freetronics/USBBoost/USBBoost.pdf

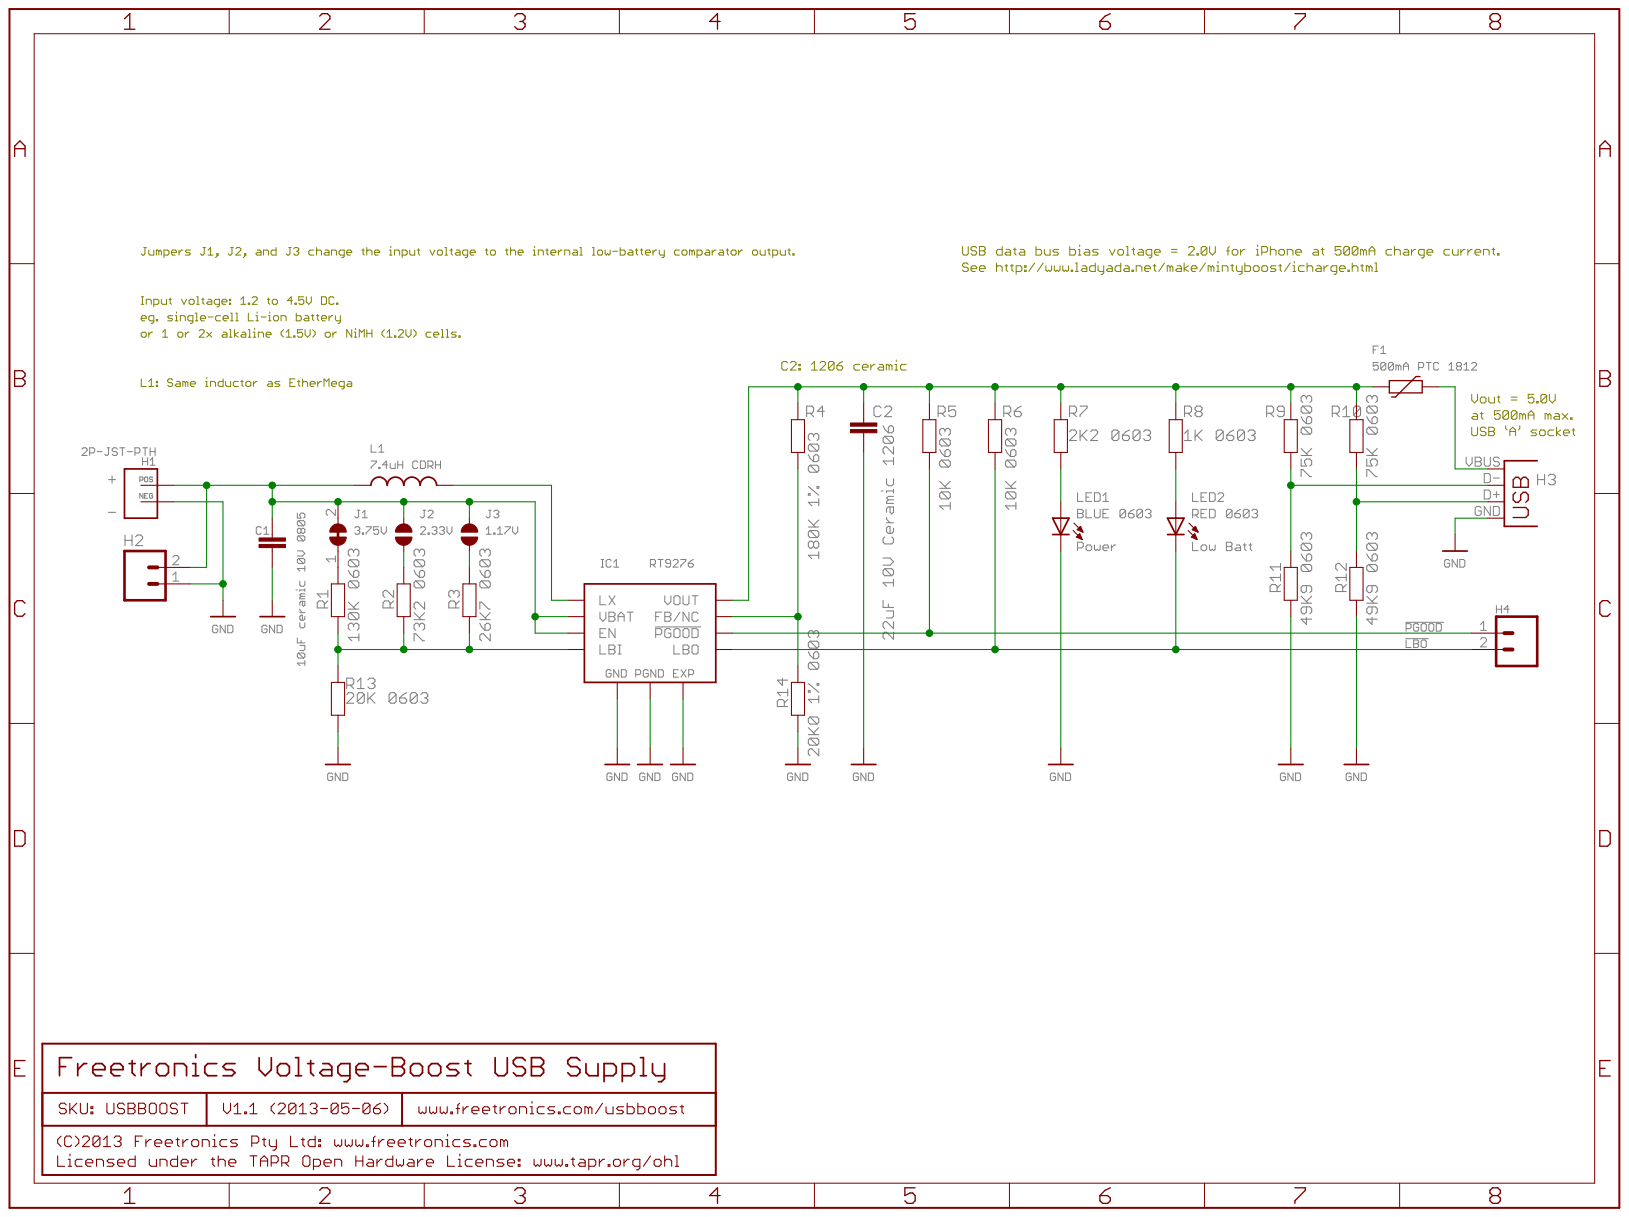
[picture p1: page 1]
