freetronics/USBBoost/USBBoost.brd

## EAGLE design USBBoost.brd (2013-05-06)

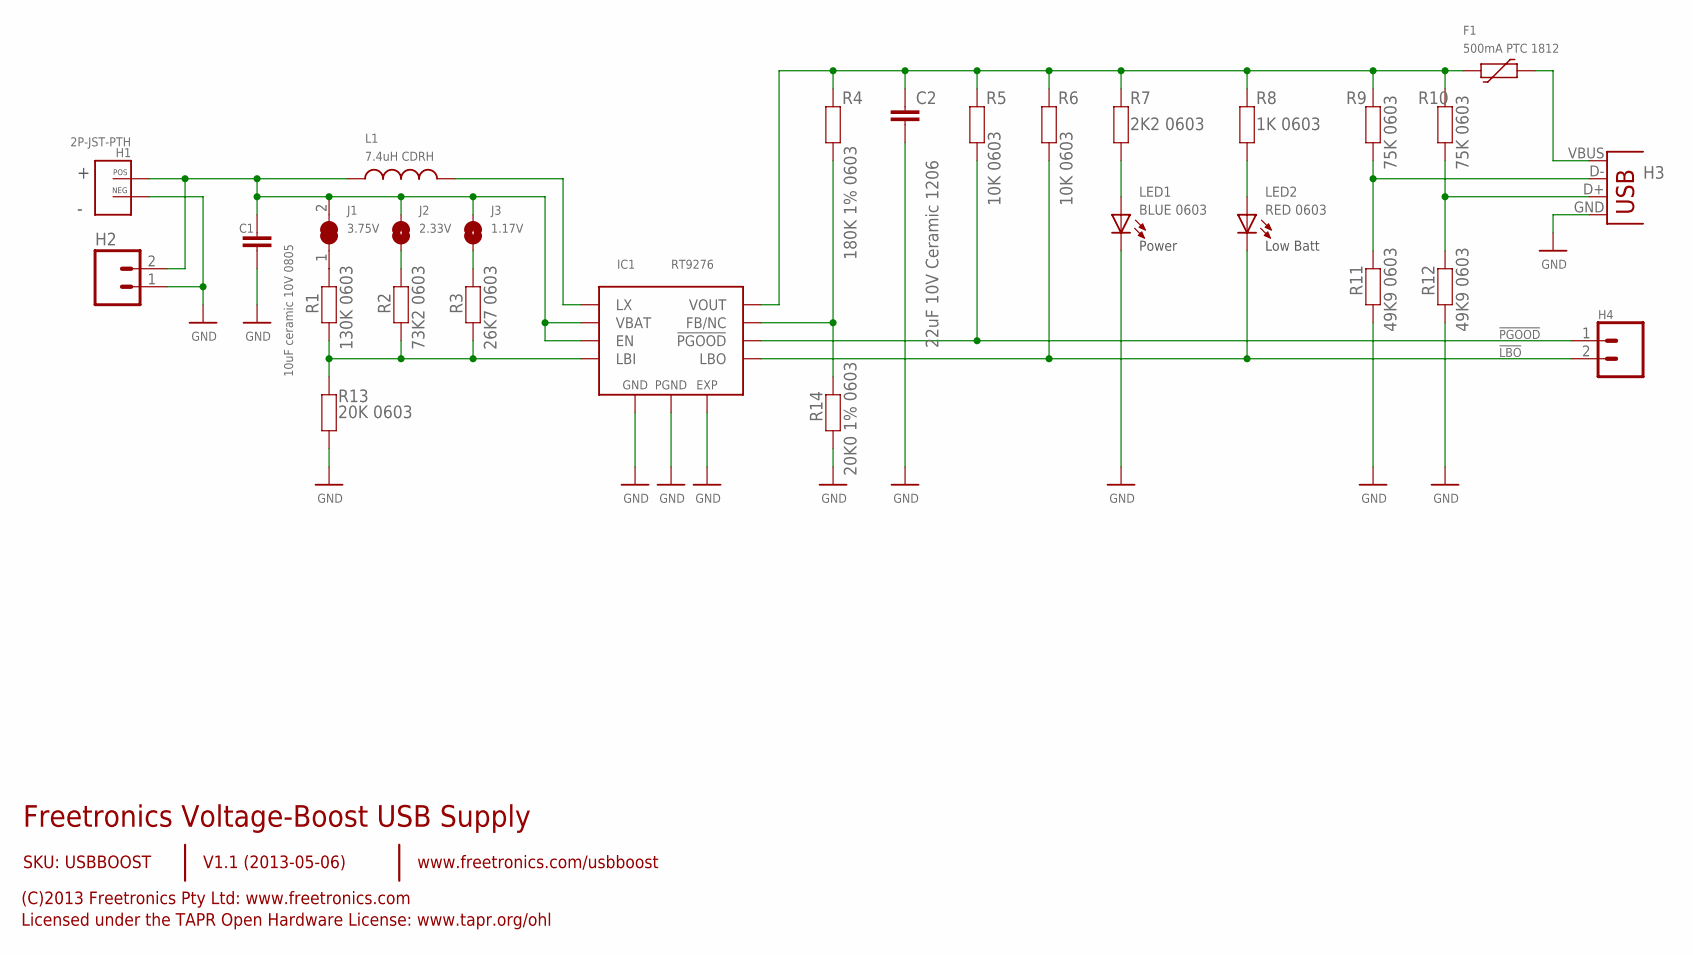
[picture p2: schematic USBBoost.sch]

Parts:
C1: 10uF ceramic 10V 0805; C0805
C2: 22uF 10V Ceramic 1206; C1206K
F1: 500mA PTC 1812; 1812
H1: 2P-JST-PTH; JST-2MM-TH-RA
H2: M02PTH; 1X02
H3: USB; USB-A-S-SILK-FEMALE
H4: Status; 1X02
IC1: RT9276; WDFN-10L-3X3
J1: 3.75V; SJC
J2: 2.33V; SJ
J3: 1.17V; SJ
L1: 7.4uH CDRH; CDRH
LED1: BLUE 0603; LED-0603
LED2: RED 0603; LED-0603
R1: 130K 0603; 0603
R2: 73K2 0603; 0603
R3: 26K7 0603; 0603
R4: 180K 1% 0603; 0603
R5, R6: 10K 0603; 0603
R7: 2K2 0603; 0603
R8: 1K 0603; 0603
R9, R10: 75K 0603; 0603
R11, R12: 49K9 0603; 0603
R13: 20K 0603; 0603
R14: 20K0 1% 0603; 0603

Connections:
!LBO: H4.2, IC1.4 (LBO), LED2.C, R6.2
!PGOOD: H4.1, IC1.8 (!PGOOD), R5.2
FB: IC1.3 (FB/NC), R4.2, R14.2
GND: C1.2, C2.2, H1.NEG, H2.1, H3.GND, IC1.5 (GND), IC1.10 (PGND), IC1.EXP, LED1.C, R11.2, R12.2, R13.1, R14.1
LBI: IC1.7 (LBI), R1.1, R2.1, R3.1, R13.2
LX: IC1.9 (LX), L1.2
unnamed: J1.1, R1.2
unnamed: H3.D-, R9.2, R11.1
unnamed: LED1.A, R7.2
unnamed: F1.2, H3.VBUS
unnamed: H3.D+, R10.2, R12.1
unnamed: J2.1, R2.2
unnamed: J3.1, R3.2
unnamed: LED2.A, R8.2
VBAT: C1.1, H1.POS, H2.2, IC1.1 (EN), IC1.6 (VBAT), J1.2, J2.2, J3.2, L1.1
VOUT: C2.1, F1.1, IC1.2 (VOUT), R4.1, R5.1, R6.1, R7.1, R8.1, R9.1, R10.1

Notes on the sheet:
Freetronics Voltage-Boost USB Supply
V1.1 (2013-05-06)
SKU: USBBOOST
(C)2013 Freetronics Pty Ltd: www.freetronics.com
Licensed under the TAPR Open Hardware License: www.tapr.org/ohl
www.freetronics.com/usbboost
Low Batt
Power

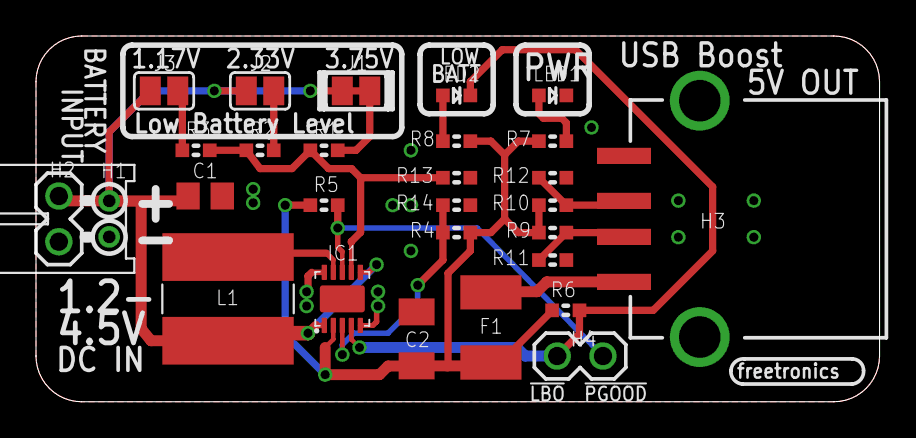
[picture p3: board USBBoost.brd from above]

Board: 2 copper layers, 46.9 x 20.3 mm, 28 parts (0 on the bottom side), 16 nets.
