freetronics/USBBoost/(commit log)

2012-06-13 Restructured schematic
    [USBBoost.brd, USBBoost.sch]
2012-06-13 Layout and schematic tweaks
    [USBBoost.brd, USBBoost.sch]
2012-06-22 Overlay improvements
    [USBBoost.brd]
2012-06-23 Removed old production files
    [USBBoost.GBL, USBBoost.GBO, USBBoost.GBS, USBBoost.GTL, USBBoost.GTO, USBBoost.GTP, USBBoost.GTS]
2012-08-21 Final tweaks and DRC for production
    [USBBoost.brd, USBBoost.sch]
2013-05-06 v1.1 release
    [USBBoost.brd, USBBoost.sch]
2014-06-18 Add schematic PDF
